wenzellabs/SQUIM_v02/SQUIM_v02_schematic.pdf

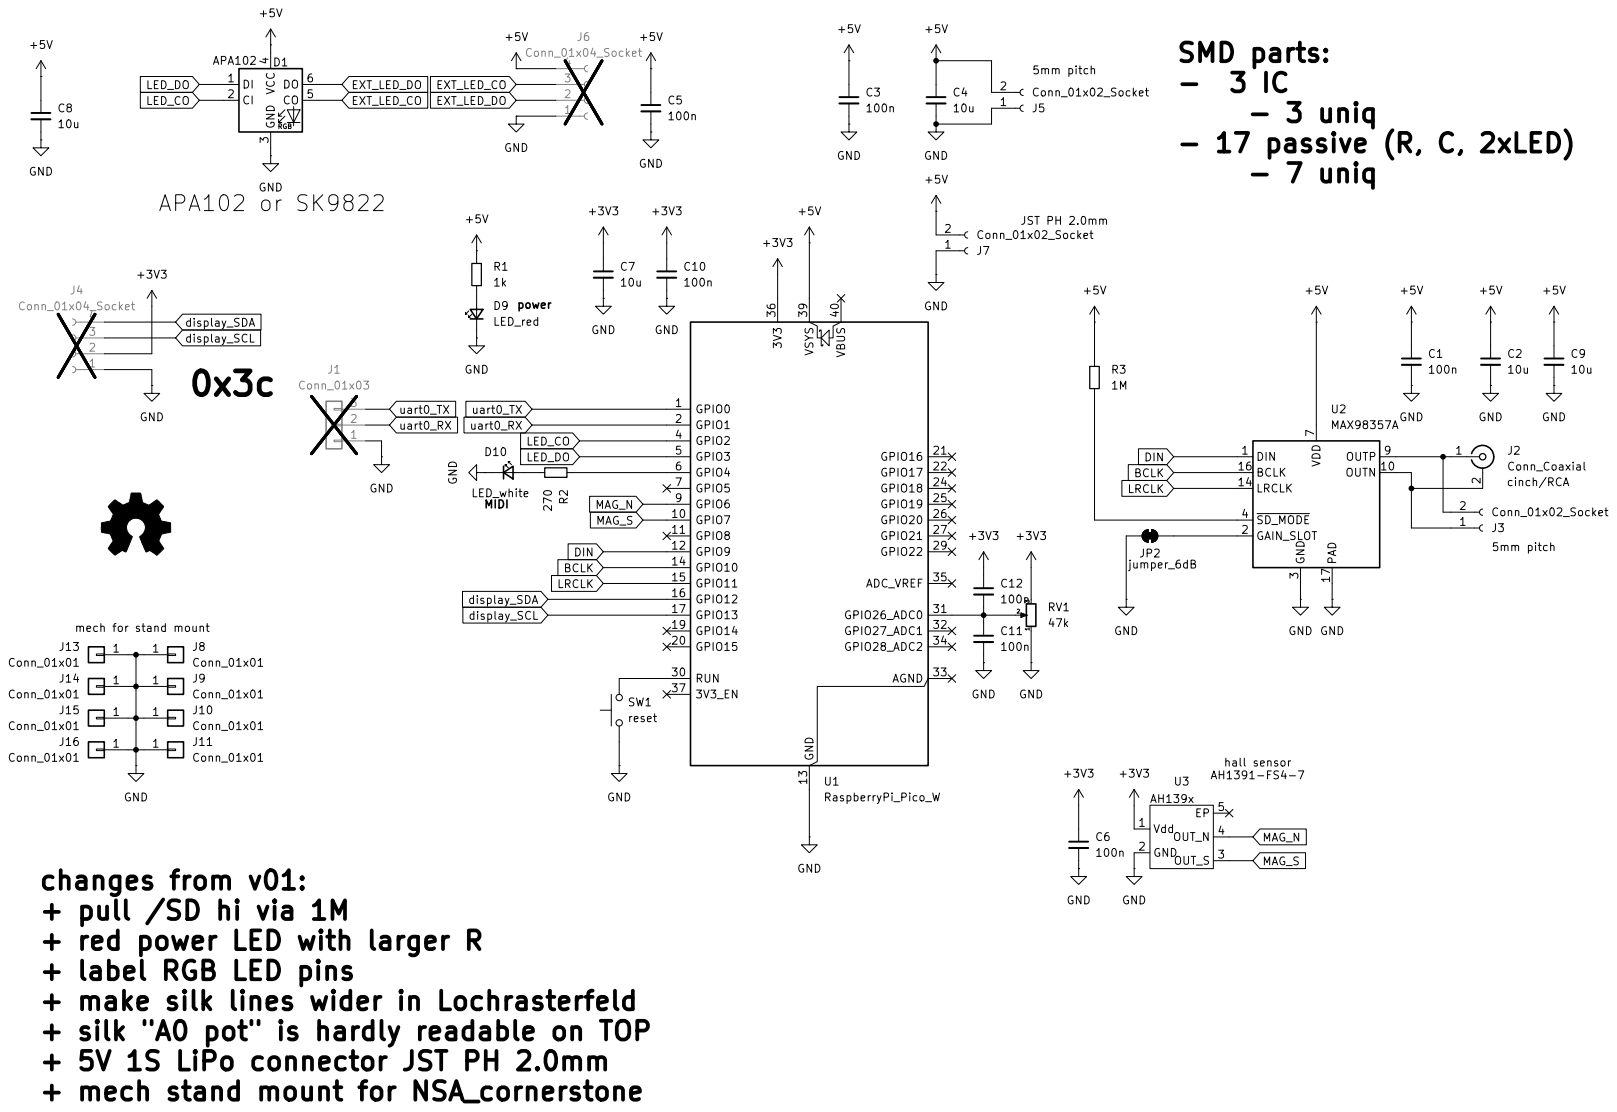
[picture p5: page 1]
