wenzellabs/SQUIM_v02/SQUIM_v02.kicad_sch

## KiCad design SQUIM_v02.kicad_sch (2024-11-09)

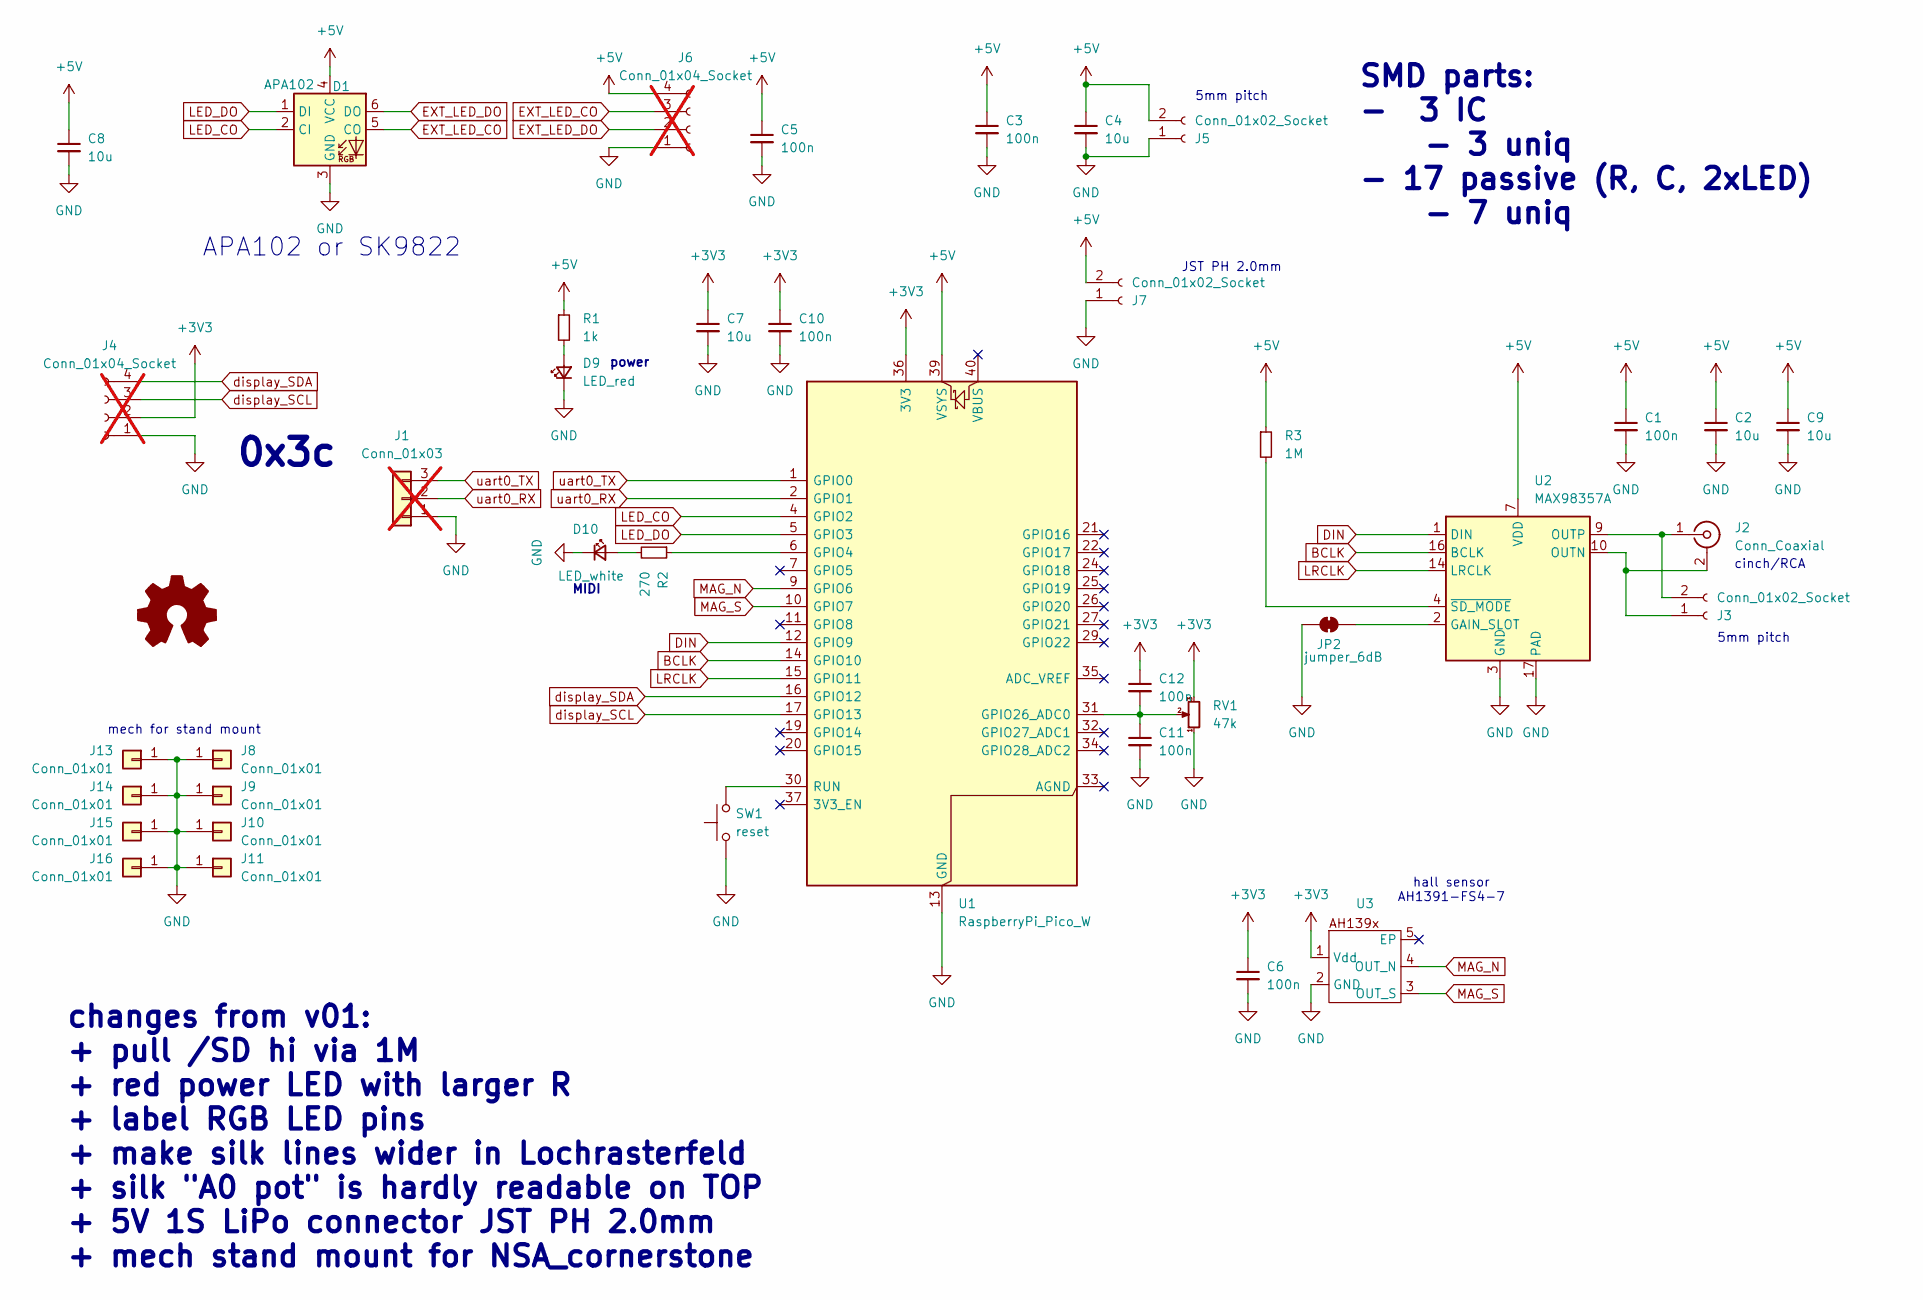
[picture p6: schematic SQUIM_v02.kicad_sch]

Parts:
C1, C3, C5, C6, C10, C11, C12: 100n; C_0603_1608Metric
C2, C4, C7, C8, C9: 10u; C_0603_1608Metric
D1: APA102; LED_RGB_5050-6
D9: LED_red; LED_0603_1608Metric
D10: LED_white; LED_0603_1608Metric
J1: Conn_01x03; PinHeader_1x03_P2.54mm_Vertical; not fitted
J2: Conn_Coaxial; conn_RCA_cinch
J3, J5: Conn_01x02_Socket; JST_NV_B02P-NV_1x02_P5.00mm_Vertical
J4: Conn_01x04_Socket; OLED_0.91_4P_I2C; not fitted
J6: Conn_01x04_Socket; PinSocket_1x04_P2.54mm_Vertical; not fitted
J7: Conn_01x02_Socket; JST_PH_B2B-PH-K_1x02_P2.00mm_Vertical
J8, J9, J10, J11, J13, J14, J15, J16: Conn_01x01; PCB_edge_pad_nopaste
JP2: jumper_6dB; SolderJumper-2_P1.3mm_Bridged_RoundedPad1.0x1.5mm
R1: 1k; R_0603_1608Metric
R2: 270; R_0603_1608Metric
R3: 1M; R_0603_1608Metric
RV1: 47k; Potentiometer_Bourns_PTV09A-1_Single_Vertical
SW1: reset; SW_Push_1P1T_NO_CK_KMR2; LCSC Part Number C221675
U1: RaspberryPi_Pico_W; RaspberryPi_Pico_Common
U2: MAX98357A; TQFN-16-1EP_3x3mm_P0.5mm_EP1.23x1.23mm
U3: UDFN-4-1EP_1x1mm_P0.65mm_EP0.48x0.48mm

Connections:
+3V3: C6.1, C7.1, C10.1, C12.1, J4.2, RV1.3, U1.36 (3V3), U3.1 (Vdd)
+5V: C1.1, C2.1, C3.1, C4.1, C5.1, C8.1, C9.1, D1.4 (VCC), J5.2, J6.4, J7.2, R1.1, R3.1, U1.39 (VSYS), U2.7 (VDD), U2.8 (VDD)
BCLK: U1.14 (GPIO10), U2.16 (BCLK)
DIN: U1.12 (GPIO9), U2.1 (DIN)
EXT_LED_CO: D1.5 (CO), J6.3
EXT_LED_DO: D1.6 (DO), J6.2
GND: C1.2, C2.2, C3.2, C4.2, C5.2, C6.2, C7.2, C8.2, C9.2, C10.2, C11.2, D1.3 (GND), D9.1 (K), D10.1 (K), J1.1, J4.1, J5.1, J6.1, J7.1, J8.1, J9.1, J10.1, J11.1, J13.1, J14.1, J15.1, J16.1, JP2.1 (A), RV1.1, SW1.1, U1.3 (GND), U1.8 (GND), U1.13 (GND), U1.18 (GND), U1.23 (GND), U1.28 (GND), U1.38 (GND), U2.3 (GND), U2.11 (GND), U2.15 (GND), U2.17 (PAD), U3.2 (GND)
LED_CO: D1.2 (CI), U1.4 (GPIO2)
LED_DO: D1.1 (DI), U1.5 (GPIO3)
LRCLK: U1.15 (GPIO11), U2.14 (LRCLK)
MAG_N: U1.9 (GPIO6), U3.4 (OUT_N)
MAG_S: U1.10 (GPIO7), U3.3 (OUT_S)
unnamed: C11.1, C12.2, RV1.2, U1.31 (GPIO26_ADC0)
unnamed: D9.2 (A), R1.2
unnamed: D10.2 (A), R2.2
unnamed: J2.1 (In), J3.2, U2.9 (OUTP)
unnamed: J2.2 (Ext), J3.1, U2.10 (OUTN)
unnamed: JP2.2 (B), U2.2 (GAIN_SLOT)
unnamed: R2.1, U1.6 (GPIO4)
unnamed: R3.2, U2.4 (~SD_MODE)
unnamed: SW1.2, U1.30 (RUN)
display_SCL: J4.3, U1.17 (GPIO13)
display_SDA: J4.4, U1.16 (GPIO12)
uart0_RX: J1.2, U1.2 (GPIO1)
uart0_TX: J1.3, U1.1 (GPIO0)

Notes on the sheet:
cinch/RCA
MIDI
JST PH 2.0mm
5mm pitch
SMD parts: - 3 IC - 3 uniq - 17 passive (R, C, 2xLED) - 7 uniq
APA102 or SK9822
0x3c
hall sensor AH1391-FS4-7
power
changes from v01: + pull /SD hi via 1M + red power LED with larger R + label RGB LED pins + make silk lines wider in Lochrasterfeld + silk "A0 pot" is hardly readable on TOP + 5V 1S LiPo connector JST PH 2.0mm + mech stand mount for NSA_cornerstone
mech for stand mount
