wenzellabs/SQUIM_v02/(commit log)

2024-11-07 initial commit, copy of SQUIM_v01
    [SQUIM_v02.kicad_sch]
2024-11-07 v01->v02 on silkscreen
2024-11-07 all the v1->v2 changes as documented in the schematic
    [SQUIM_v02-B_Cu.gbr, SQUIM_v02-B_Mask.gbr, SQUIM_v02-B_Paste.gbr, SQUIM_v02-Edge_Cuts.gbr, SQUIM_v02-F_Cu.gbr, SQUIM_v02-F_Mask.gbr, SQUIM_v02-F_Paste.gbr, SQUIM_v02-F_Silkscreen.gbr]
2024-11-09 add features description, pdf schematic
    [SQUIM_v02.kicad_sch]
